UF-Smart-Glasses/Smart-Glasses/hardware/sim/power_tree.asc

C1: cap; 10µ
C2: cap; 10µ
C3: cap; {22u*derate}; Rser={esr}
C4: cap; {22u*derate}; Rser={esr}
C5: cap; {22u*derate}; Rser={esr}
C6: cap; 0.1µ
C7: cap; 4.7µ
C8: cap; 4.7µ
C9: cap; {c1Gnd}
C10: cap; {c1Ff}
C11: cap; {22u*derate}
C12: cap; {10u*derate}
C13: cap; {4.7u*derate}
C14: cap; {4.7u*derate}
I1: current; PWL(0 0 50u 50m 0.8m 50m 0.9m 100m 1.5m 100m 1.502m 350m 2.0m 350m 2.002m 100m)
L1: ind; 1µ; Rser=1m
R1: res; 1Meg
R2: res; 180k
R4: res; 100K
R5: res; {2.8/iCam28}
R6: res; {1.5/iCam15}
RBAT: res; {rBat}
U1: TPS63060_TRANS
U2: ldoBehav
U3: ldoBehav; vSet=1.5 rOn=1 iq=40u
VIN: voltage; {vBat}
Named nets: VIN, SW1, SW2, VOUT, FB, VAUX, PG, 0, VBAT, CAM_2V8, CAM_1V5
.tran 0 2.5m 0 10n
.lib models\\TPS63060_TRANS.lib
.save V(vout) V(pg) V(vin) I(L1) V(cam_2v8) V(cam_1v5)
.param rBat=0.2 vBat=3.7
.lib models\\ldo_behav.lib
.param iCam28=34m iCam15=64m
.meas TRAN vOutPeakStartup MAX V(vout) FROM 0 TO 0.8m
.meas TRAN vOutPreBurst AVG V(vout) FROM 1.3m TO 1.5m
.meas TRAN vOutMinBurst MIN V(vout) FROM 1.5m TO 2.2m
.meas TRAN vOutDroop PARAM vOutPreBurst-vOutMinBurst
.meas TRAN cam28Min MIN V(cam_2v8) FROM 1m TO 2.5m
.meas TRAN vinMin MIN V(vin) FROM 1.5m TO 2.2m
.step param vBat list 3.0 3.3 3.7 4.2
.param cOut=22u
.step param esr list 2m 10m 30m
.meas TRAN vOutIdleMax MAX V(vout) FROM 1m TO 1.5m
.meas TRAN tOverStart WHEN V(vout)=3.6 RISE=1
.meas TRAN tOverEnd WHEN V(vout)=3.6 FALL=1
.param c1Gnd={if(variant==1,10p,1e-18)} c1Ff={if(variant==2,10p,1e-18)}
.param esr=5m
.step param derate list 1 0.5 0.42
.param variant=1 vBat=4.2 rBat=0.2 esr=5m
.param derate=1
