UF-Smart-Glasses/Smart-Glasses/(commit log)

2026-10-05 [5] Add battery model and behavioral LDOs
2026-10-05 [5] Add VIN, capacitor, ESR, and C1 sweeps; correct rail capacitance
